tystowell/RP2040_Board_KiCAD/RP2040_Board.kicad_pcb

## KiCad design RP2040_Board.kicad_pcb (2021-06-02)

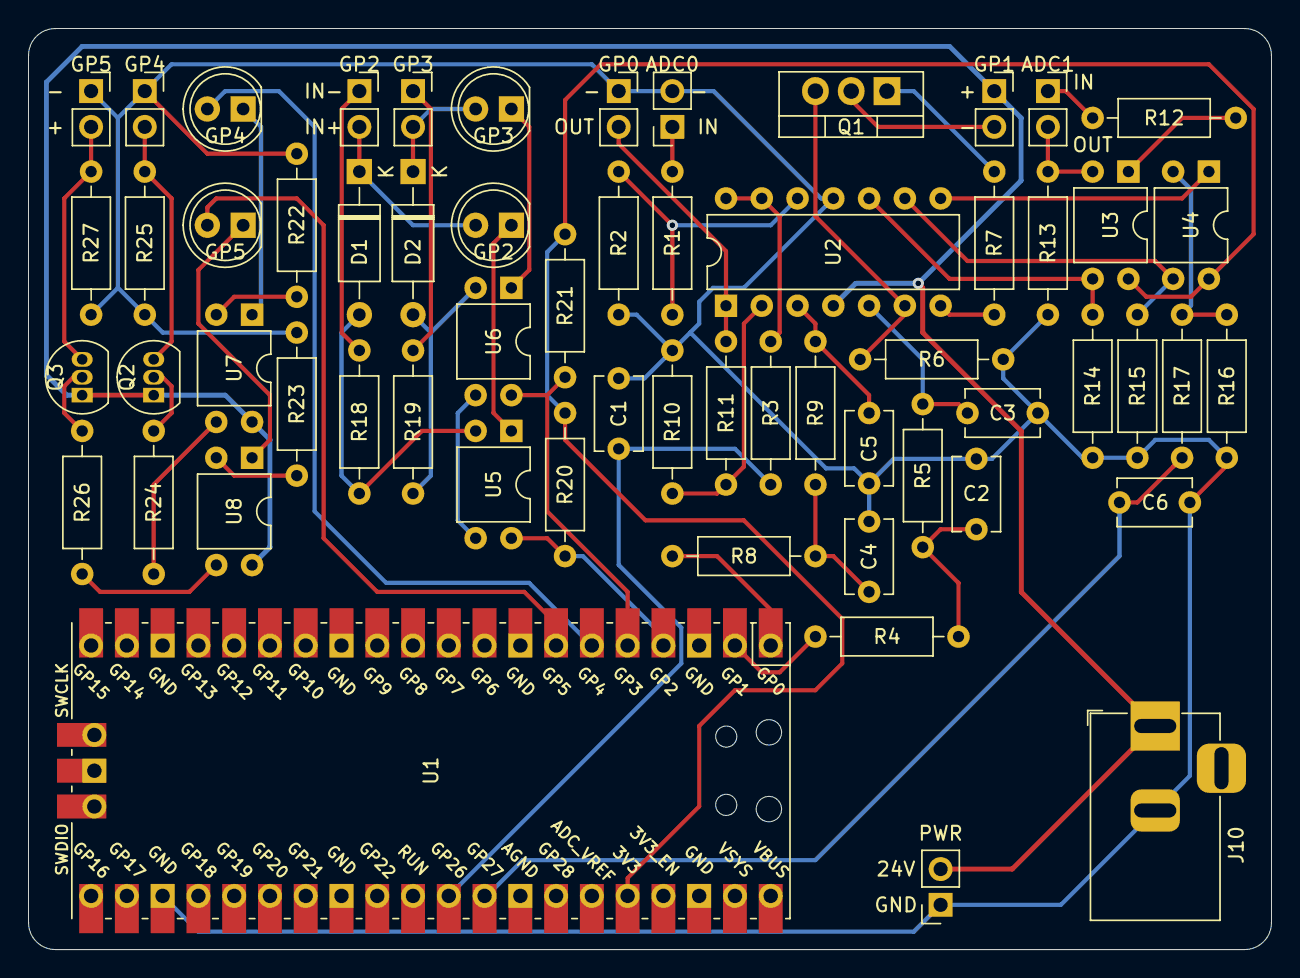
[picture p1: board RP2040_Board.kicad_pcb from above]

Board: 2 copper layers, 88.3 x 65.4 mm, 60 parts (0 on the bottom side), 49 nets.

Parts:
ADC0: V_IN; PinSocket_1x02_P2.54mm_Vertical
ADC1: mA_IN; PinSocket_1x02_P2.54mm_Vertical
C1: .47μ; C_Disc_D5.1mm_W3.2mm_P5.00mm
C2, C3, C4, C5: 2.2μ; C_Disc_D5.1mm_W3.2mm_P5.00mm
C6: 2.2µ; C_Disc_D5.1mm_W3.2mm_P5.00mm
D1, D2: D; D_A-405_P10.16mm_Horizontal
GP0: V_OUT; PinSocket_1x02_P2.54mm_Vertical
GP1: mA_OUT; PinSocket_1x02_P2.54mm_Vertical
GP2, GP3: DIG_IN; PinSocket_1x02_P2.54mm_Vertical
GP2#2, GP3#2, GP4#2, GP5#2: LED; LED_D5.0mm
GP4, GP5: DIG_OUT; PinSocket_1x02_P2.54mm_Vertical
J10: 24V DC Power; BarrelJack_Horizontal
PWR: GND-24V; PinSocket_1x02_P2.54mm_Vertical
Q1: IRF510N; TO-220-3_Vertical
Q2, Q3: BC337; TO-92_Inline
R1, R11: 22k; R_Axial_DIN0207_L6.3mm_D2.5mm_P10.16mm_Horizontal
R2, R10: 10k; R_Axial_DIN0207_L6.3mm_D2.5mm_P10.16mm_Horizontal
R3, R4, R5, R8, R9, R17: 2.2k; R_Axial_DIN0207_L6.3mm_D2.5mm_P10.16mm_Horizontal
R6, R12, R16: 150; R_Axial_DIN0207_L6.3mm_D2.5mm_P10.16mm_Horizontal
R7: 10; R_Axial_DIN0207_L6.3mm_D2.5mm_P10.16mm_Horizontal
R13: 1M; R_Axial_DIN0207_L6.3mm_D2.5mm_P10.16mm_Horizontal
R14, R15: 47; R_Axial_DIN0207_L6.3mm_D2.5mm_P10.16mm_Horizontal
R18, R19, R25, R27: 4.7k; R_Axial_DIN0207_L6.3mm_D2.5mm_P10.16mm_Horizontal
R20, R21: 20k; R_Axial_DIN0207_L6.3mm_D2.5mm_P10.16mm_Horizontal
R22, R23, R24, R26: 470; R_Axial_DIN0207_L6.3mm_D2.5mm_P10.16mm_Horizontal
U1: Pico; RPi_Pico_SMD_TH
U2: LM324; DIP-14_W7.62mm
U3, U4, U5, U6, U7, U8: PC817; DIP-4_W7.62mm

Connections:
3.3V: R20.1, R21.1, U1.36, U3.4, U4.4
24V: GP1.1, J10.1, PWR.2, Q2.1, Q3.1, U2.4, U7.4, U8.4
/10V to 3.3V Input/IN: ADC0.1, R1.2
/10V to 3.3V Input/OUT: C1.1, R3.1, U1.31
/20mA to 3.3V Input/C_IN: ADC1.1, R12.2
/20mA to 3.3V Input/C_OUT: ADC1.2, R13.2, U3.2
/20mA to 3.3V Input/OUT: C6.1, R17.1, U1.32
/Digital Input/IN+1: D1.1, GP2.2, GP2#2.2
/Digital Input/IN+2: D2.1, GP3.2, GP3#2.2
/Digital Input/IN-1: GP2.1, R18.1
/Digital Input/IN-2: GP3.1, R19.1
/Digital Input/OUT1: R20.2, U1.4, U5.4
/Digital Input/OUT2: R21.2, U1.5, U6.4
/Digital Output/IN1: GP4#2.2, U1.6
/Digital Output/IN2: GP5#2.2, U1.7
/Digital Output/OUT1: GP4.2, Q2.3, R25.2
/Digital Output/OUT2: GP5.2, Q3.3, R27.2
/PWM to 10V Output/OUT: GP0.2, R11.1, U2.1
/PWM to 10V Output/PWM: R8.2, U1.1
/PWM to 20mA Output/OUT: GP1.2, Q1.2
/PWM to 20mA Output/PWM: R4.2, U1.2
GND: ADC0.2, C1.2, C2.2, C3.2, C4.2, C5.2, C6.2, GP0.1, GP4.1, GP5.1, J10.2, PWR.1, R2.1, R6.2, R10.2, R13.1, R14.1, R15.1, R16.1, R22.1, R23.1, R25.1, R27.1, U1.23, U2.11, U5.3, U6.3
unnamed: C2.1, R4.1, R5.2
unnamed: C3.1, R5.1, U2.5
unnamed: C4.1, R8.1, R9.2
unnamed: C5.1, R9.1, U2.3
unnamed: D1.2, R18.2, U5.2
unnamed: D2.2, R19.2, U6.2
unnamed: GP2#2.1, U5.1
unnamed: GP3#2.1, U6.1
unnamed: GP4#2.1, U7.1
unnamed: GP5#2.1, U8.1
unnamed: Q1.1, R7.1
unnamed: Q1.3, R6.1, U2.6
unnamed: Q2.2, R24.2
unnamed: Q3.2, R26.2
unnamed: R1.1, R2.2, U2.12
unnamed: R3.2, U2.13, U2.14
unnamed: R7.2, U2.7
unnamed: R10.1, R11.2, U2.2
unnamed: R12.1, U3.1
unnamed: R14.2, U2.10, U3.3
unnamed: R15.2, U2.9, U4.3
unnamed: R16.2, R17.2, U4.2
unnamed: R22.2, U7.2
unnamed: R23.2, U8.2
unnamed: R24.1, U7.3
unnamed: R26.1, U8.3
unnamed: U2.8, U4.1
