tystowell/RP2040_Board_KiCAD/(commit log)

2021-05-20 10V Output Circuit First Revision
    [10V_OUT.sch, RP2040_Board.kicad_pcb, RP2040_Board.sch]
2021-05-20 Added a library for the Pi Pico
    [RP2040_Board.sch]
2021-05-20 10V Input Circuit First Revision
    [10V_IN.sch, 10V_OUT.sch, RP2040_Board.sch]
2021-05-24 Added PWM to 20mA Output Subcircuit
    [10V_IN.sch, 10V_OUT.sch, 20mA_OUT.sch, RP2040_Board.sch]
2021-05-24 Added 20mA to 3.3V Input Subcircuit
    [10V_IN.sch, 10V_OUT.sch, 20mA_IN.sch, 20mA_OUT.sch, RP2040_Board.sch]
2021-05-24 Op amp power supply in 20mA_IN switched to 5V
    [10V_OUT.sch, 20mA_IN.sch, RP2040_Board.sch]
2021-05-25 Previous current input circuit was reaching op amp saturation. Possible solution may involve transistor, but for now, higher power supply is sufficient.
    [20mA_IN.sch, RP2040_Board.sch]
2021-05-25 Added Optically Isolated Digital Input
    [10V_IN.sch, 10V_OUT.sch, 20mA_IN.sch, 20mA_OUT.sch, DIG_IN.sch, PWM_OUT.sch, RP2040_Board.sch]
2021-05-25 Comments and Notation for clarity
    [10V_IN.sch, 10V_OUT.sch, 20mA_IN.sch, 20mA_OUT.sch, DIG_IN.sch, RP2040_Board.sch]
2021-05-26 Cleanup, added second digital input, and created sheet for digital output (currently empty)
    [10V_IN.sch, 10V_OUT.sch, 20mA_IN.sch, 20mA_OUT.sch, DIG_IN.sch, DIG_OUT.sch, RP2040_Board.sch]
2021-05-26 Testing and adjustments
    [10V_IN.sch, 10V_OUT.sch, 20mA_IN.sch, 20mA_OUT.sch, DIG_IN.sch, DIG_OUT.sch, POWER.sch, RP2040_Board.sch]
2021-05-26 Basic Digital Output Circuit (First Revision, UNTESTED)
    [DIG_OUT.sch, POWER.sch, RP2040_Board.sch]
2021-05-27 Footprint Association
    [10V_IN.sch, 10V_OUT.sch, 20mA_IN.sch, 20mA_OUT.sch, DIG_IN.sch, DIG_OUT.sch, POWER.sch, RP2040_Board.sch]
2021-05-27 Fixed a couple of discrepancies between my test circuit and the schematic
    [10V_IN.sch, 20mA_IN.sch, 20mA_OUT.sch]
2021-05-27 Status LED was ruining the reverse voltage protection LED's purpose
    [DIG_IN.sch, DIG_OUT.sch]
2021-05-31 Finished 1st revision of 24V digital output circuit
    [10V_OUT.sch, 20mA_IN.sch, 20mA_OUT.sch, DIG_IN.sch, DIG_OUT.sch]
2021-05-31 Cleanup and ERC compliance. Probably ready for Pcbnew after footprint association is done.
    [20mA_IN.sch, DIG_OUT.sch, POWER.sch, RP2040_Board.sch]
2021-05-31 Finished component association
    [POWER.sch, RP2040_Board.sch]
2021-05-31 Started PCB board design (TH, V1)
    [RP2040_Board.kicad_pcb]
2021-06-02 More PCB design work
    [RP2040_Board.kicad_pcb]
2021-06-02 Everything in the PCB is now wired together
    [RP2040_Board.kicad_pcb]
2021-06-02 Added a copper pad for ground
    [RP2040_Board.kicad_pcb]
2021-06-02 Forgot to add a small trace. Now the board is complete.
    [RP2040_Board.kicad_pcb]
2021-06-02 Adjusted 24V traces to be .35mm and recreated fill zone
    [RP2040_Board.kicad_pcb]
